khb123456/stm32f103c8t6-balance_car/硬件/平衡车PCB原理图.pdf

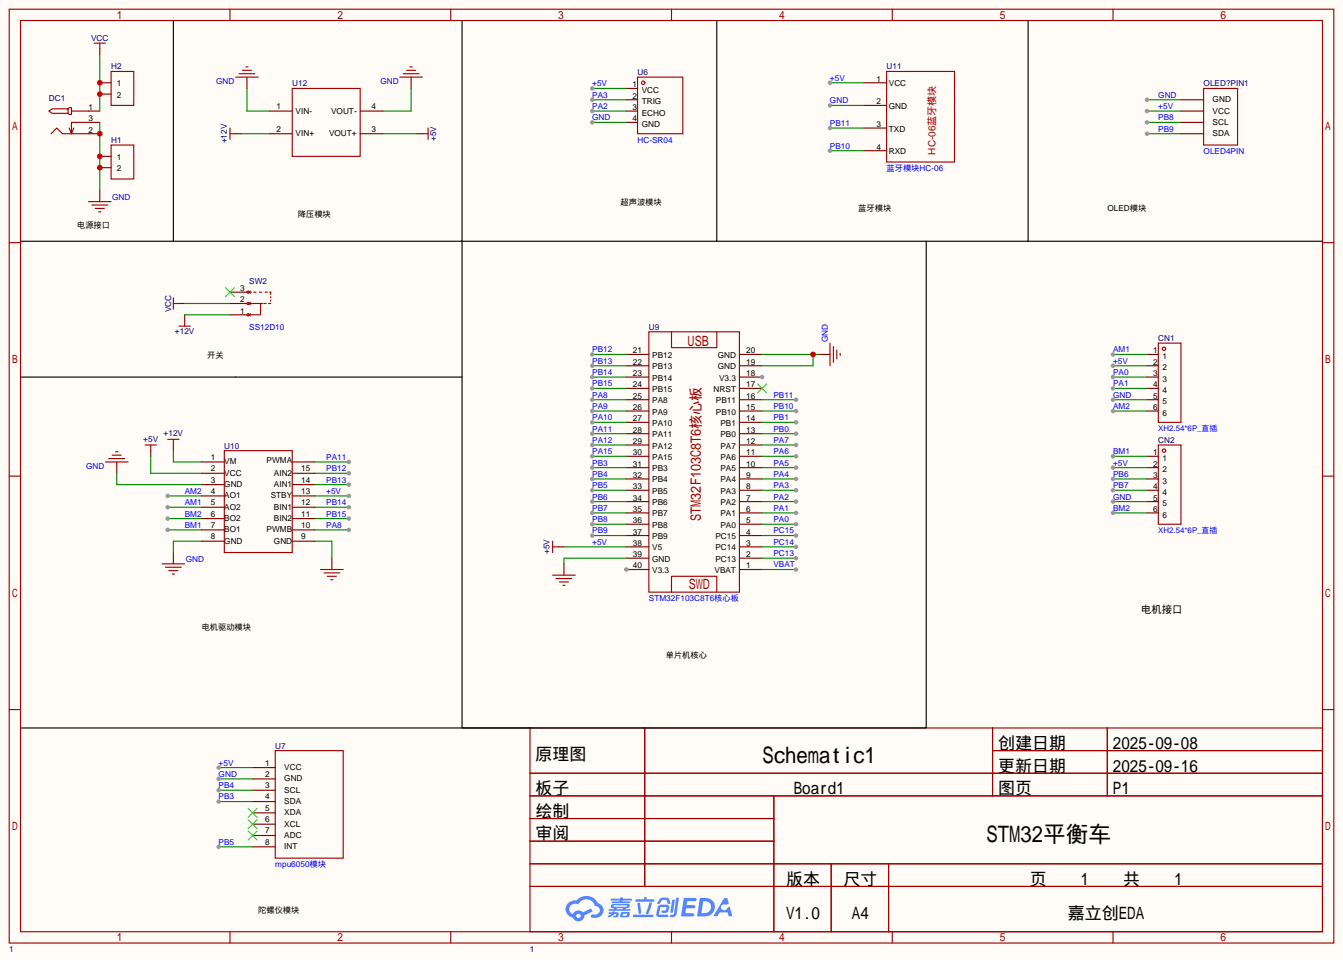
[picture p1: page 1]

原理图 | Schematic1 | 创建日期 | 2025-09-08

更新日期 | 2025-09-16

板子 | Board1 | 图页 | P1
绘制 | | STM32平衡车
审阅

V1.0 | A4 | 嘉立创EDA
