khb123456/stm32f103c8t6-balance_car/(list of files, drawings)

Other design files:
硬件/STM32平衡车PCB.eprj
