khb123456/stm32f103c8t6-balance_car/软件/stm32_balance car/Core/Src/main.c

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
/* Includes ------------------------------------------------------------------*/
#include "main.h"
#include "i2c.h"
#include "tim.h"
#include "usart.h"
#include "gpio.h"

/* USER CODE BEGIN Includes */
#include "OLED.h"
#include "MPU6050.h"
#include "stdio.h"
#include "sr04.h"
#include "motor.h"
#include "encoder.h"
#include "string.h"
#include "task.h"
#include "pid.h"
#include "stdlib.h"
/* USER CODE END Includes */


/* USER CODE BEGIN PV */
int16_t AX, AY, AZ, GX, GY, GZ,Tem;
float AngleAcc;			//由加速度计得到的角度值
float AngleGyro;		//由陀螺仪得到的角度值，执行互补滤波后，此值基本与Angle相等
float Angle;			//互补滤波后的角度值，准确且无漂移


int Encoder_Left,Encoder_Right;
extern float distance;
uint8_t rx_buf[2];
char uart_buf[128];
uint8_t Rx_Flag;
char RxPacket[100];
int16_t LeftPWM, RightPWM;			//左PWM，右PWM
int16_t Ave_PWM, Dif_PWM;				//平均PWM，差分PWM

float LeftSpeed, RightSpeed;		//左速度，右速度
float AveSpeed, DifSpeed;			//平均速度，差分速度
uint8_t Run_Flag;
volatile uint8_t control_flag=0;
PID_TypeDef angle_pid={
	.Kp=0.0f,
	.Ki=0.0f,
	.Kd=0.0f,
	.out_max=90.0f
};
PID_TypeDef speed_pid={
	.Kp=0.0f,
	.Ki=0.0f,
	.Kd=0.0f,
	.integral_max=20,
	.out_max=8.0f
};
PID_TypeDef turn_pid=
{
	.Kp=0.0f,
	.Ki=0.0f,
	.Kd=0.0f,
	.out_max=20.0f
};
/* USER CODE END PV */

void SystemClock_Config(void);
/* USER CODE BEGIN PFP */
void Read(void);
int fputc(int c,FILE *stream);
static void OLED_Proc(void);
void Set_params(void);
void Control(void);

// DWT初始化，开启CYCCNT计数器
void DWT_Init(void)
{
    // 1. 开启DWT和ITM的时钟（必须）
    CoreDebug->DEMCR |= CoreDebug_DEMCR_TRCENA_Msk; 
    // 2. 关闭CYCCNT计数器
    DWT->CTRL &= ~DWT_CTRL_CYCCNTENA_Msk;
    // 3. 清零CYCCNT计数器
    DWT->CYCCNT = 0;
    // 4. 开启CYCCNT计数器
    DWT->CTRL |= DWT_CTRL_CYCCNTENA_Msk;
}

// 读取当前CYCCNT计数器的值（单位：CPU时钟周期）
static inline uint32_t DWT_GetCycle(void)
{
    return DWT->CYCCNT;
}

// 延时函数：微秒级延时（单位：us）
void DWT_Delay_us(uint32_t us)
{
    uint32_t cycles = us * (SystemCoreClock / 1000000); // 换算成需要等待的周期数
    uint32_t start = DWT_GetCycle();
    while ((DWT_GetCycle() - start) < cycles);
}

// 测量一段代码的执行时间（返回单位：us）
float DWT_MeasureTime_us(void (*func)(void))
{
    uint32_t start, end;
    start = DWT_GetCycle();
    func();  // 执行你要测的函数，比如OLED_DMA_Refresh()
    end = DWT_GetCycle();
    return (float)(end - start) / (SystemCoreClock / 1000000);
}
/* USER CODE END PFP */

/**
  * @brief  The application entry point.
  * @retval int
  */
int main(void)
{

  /* MCU Configuration--------------------------------------------------------*/

  /* Reset of all peripherals, Initializes the Flash interface and the Systick. */
  HAL_Init();

  /* Configure the system clock */
  SystemClock_Config();

  /* Initialize all configured peripherals */
  MX_GPIO_Init();
  MX_I2C1_Init();
  MX_TIM3_Init();
  MX_TIM1_Init();
  MX_TIM2_Init();
  MX_TIM4_Init();
  MX_USART3_UART_Init();
  /* USER CODE BEGIN 2 */
  IIC_Init();
  OLED_Init();  
  MPU6050_Init();
  OLED_Clear();
  HAL_TIM_PWM_Start(&htim1,TIM_CHANNEL_1);
  HAL_TIM_PWM_Start(&htim1,TIM_CHANNEL_4);
  HAL_TIM_Encoder_Start(&htim2,TIM_CHANNEL_ALL);
  HAL_TIM_Encoder_Start(&htim4,TIM_CHANNEL_ALL);
  HAL_UART_Receive_IT(&huart3,rx_buf,1);
  Load(0,0);
  MPU6050_SetMode(MODE_COMPLEMENTARY);
  HAL_TIM_Base_Start_IT(&htim3);
  DWT_Init();
  /* USER CODE END 2 */

  /* Infinite loop */
  /* USER CODE BEGIN WHILE */
  PID_Init(&angle_pid);
  PID_Init(&speed_pid);
  PID_Init(&turn_pid);
  Run_Flag=1;
  while (1)
  {
	  Set_params();  
	  if(control_flag)
	  {
		  control_flag=0;
		  Control();
	  }
  }
    /* USER CODE END WHILE */

}

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
/* USER CODE BEGIN 4 */
void Read(void)
{
	static float AveSpeed_Filtered = 0;
	Encoder_Left=Read_Speed(&htim2);
	Encoder_Right=-Read_Speed(&htim4);
	
	LeftSpeed=Encoder_Left/13.0f/4.0f/20.0f/0.01f;
	RightSpeed=Encoder_Right/13.0f/4.0f/20.0f/0.01f;
	
	AveSpeed_Filtered = AveSpeed_Filtered * 0.8f + ((LeftSpeed+RightSpeed)/2.0f) * 0.2f;
	AveSpeed = AveSpeed_Filtered;
	DifSpeed=LeftSpeed-RightSpeed;
	
}

int fputc(int c,FILE *stream)
{
	uint8_t ch[1]={c};
	HAL_UART_Transmit(&huart3,ch,1,0xFFFF);
	return c;
}

void Set_params(void)
{
	if(Rx_Flag==1)
	{
		char *Tag=strtok(RxPacket,",");
		if(strcmp(Tag,"slider")==0)
		{
			char *Name=strtok(NULL,",");
			char *Value=strtok(NULL,",");
			
			if(strcmp(Name,"angle_kp")==0)
			{
				angle_pid.Kp=atof(Value);
			}
			else if(strcmp(Name,"angle_ki")==0)
			{
				angle_pid.Ki=atof(Value);
			}
			else if(strcmp(Name,"angle_kd")==0)
			{
				angle_pid.Kd=atof(Value);
			}
			else if(strcmp(Name,"speed_kp")==0)
			{
				speed_pid.Kp=atof(Value);
			}
			else if(strcmp(Name,"speed_ki")==0)
			{
				speed_pid.Ki=atof(Value);
			}
			else if(strcmp(Name,"speed_kd")==0)
			{
				speed_pid.Kd=atof(Value);
			}
			else if(strcmp(Name,"turn_kp")==0)
			{
				turn_pid.Kp=atof(Value);
			}
			else if(strcmp(Name,"turn_ki")==0)
			{
				turn_pid.Ki=atof(Value); 
			}
			else if(strcmp(Name,"turn_kd")==0)
			{
				turn_pid.Kd=atof(Value);
			}

		}
		else if (strcmp(Tag, "joystick") == 0)			//Tag为joystick，收到摇杆数据包
			{
				int8_t LH = atoi(strtok(NULL, ","));		//提取数据2，定义为摇杆值LH
				int8_t LV = atoi(strtok(NULL, ","));		//提取数据3，定义为摇杆值LV
				int8_t RH = atoi(strtok(NULL, ","));		//提取数据4，定义为摇杆值RH
				int8_t RV = atoi(strtok(NULL, ","));		//提取数据5，定义为摇杆值RV
				
				/*执行摇杆操作*/
				speed_pid.target = LV / 25.0;	//摇杆值LV缩放后，控制速度环目标值，前后行进控制
				turn_pid.target = RH / 2;				//摇杆值RH缩放后，控制差分PWM，左右转弯控制
			}
		
			Rx_Flag=0;

	}
//	printf("[plot,%f,%f]",angle_pid.target,angle_pid.actual);
}

void Control(void)
{
		MPU6050_Mode_Update();
		angle_pid.actual = MPU6050_GetPitch();
//		OLED_Clear();
//	    OLED_Printf(0,0,12,"Pitch:%f",angle_pid.actual);
//		OLED_Update();
//	printf("Pitch:%f\r\n",angle_pid.actual);
		 /* 超限保护 */
		if (angle_pid.actual > 50.0f || angle_pid.actual < -50.0f) 
		{
			Load(0,0);
			Run_Flag=0;
		}
		if(Run_Flag)
		{
		speed_pid.actual=AveSpeed;

		PID_Calculate(&speed_pid);
		angle_pid.target=-speed_pid.out-2.95f;
		
		PID_Calculate(&angle_pid);
		Ave_PWM = -((int)angle_pid.out);
					
		turn_pid.actual=DifSpeed;
		PID_Calculate(&turn_pid);
		Dif_PWM=turn_pid.out;
			
		LeftPWM = Ave_PWM + Dif_PWM/2;
		RightPWM = Ave_PWM - Dif_PWM/2;

		/* 输出限幅 */
		if (LeftPWM > 100) LeftPWM = 100;
		if (LeftPWM < -100) LeftPWM = -100;
		if (RightPWM > 100) RightPWM = 100;
		if (RightPWM < -100) RightPWM = -100;

		Load(LeftPWM, RightPWM);
	    }
		else
		{
		Load(0,0);
		}
	
}
void HAL_UART_RxCpltCallback(UART_HandleTypeDef *huart)
{
	static uint8_t RxState=0;
	static uint8_t pRxPacket=0;

	if(huart->Instance==USART3)
	{
		if(RxState==0)
		{
			if(rx_buf[0]=='['&&Rx_Flag==0)
			{
				RxState=1;
				pRxPacket=0;
			}
		}
		
		else if(RxState==1)
		{
			if(rx_buf[0]==']')
			{
				RxState=0;
				RxPacket[pRxPacket]='\0';
				Rx_Flag=1;
			}
			else
		{
			RxPacket[pRxPacket]=rx_buf[0];
			pRxPacket++;
		}
		}

		HAL_UART_Receive_IT(&huart3,rx_buf,1);
	}
}

void HAL_TIM_PeriodElapsedCallback(TIM_HandleTypeDef *htim)
{
	static uint16_t Count0,Count1;
	if (htim->Instance == TIM3) 
	 {
		Count0++;
		 if(Count0>=10)
		 {
			Count0=0;
			control_flag=1;	
		 }
		 Count1++;
		 if(Count1>=10)
		 {
			Count1=0;
			 Read();
		 }
	 
	 }
}
/* USER CODE END 4 */
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
