khb123456/stm32f103c8t6-balance_car/软件/stm32_balance car/MDK-ARM/.eide/eide.yml

version: "4.1"
name: stm32_balance car
type: ARM
deviceName: null
packDir: null
srcDirs: []
virtualFolder:
  name: <virtual_root>
  files: []
  folders:
    - name: Application
      files: []
      folders:
        - name: MDK-ARM
          files:
            - path: startup_stm32f103xb.s
          folders: []
        - name: User
          files: []
          folders:
            - name: Core
              files:
                - path: ../Core/Src/OLED.c
                - path: ../Core/Inc/OLED.h
                - path: ../Core/Inc/OLED_Font.h
                - path: ../Core/Src/OLED_Font.c
                - path: ../Core/Src/MPU6050.c
                - path: ../Core/Inc/MPU6050.h
                - path: ../Core/Inc/MyI2C.h
                - path: ../Core/Src/MyI2C.c
                - path: ../Core/Src/sr04.c
                - path: ../Core/Inc/sr04.h
                - path: ../Core/Src/motor.c
                - path: ../Core/Inc/motor.h
                - path: ../Core/Src/encoder.c
                - path: ../Core/Inc/encoder.h
                - path: ../Core/Inc/task.h
                - path: ../Core/Src/inv_mpu.c
                - path: ../Core/Src/inv_mpu_dmp_motion_driver.c
                - path: ../Core/Inc/dmpKey.h
                - path: ../Core/Inc/dmpmap.h
                - path: ../Core/Inc/inv_mpu.h
                - path: ../Core/Inc/inv_mpu_dmp_motion_driver.h
                - path: ../Core/Inc/pid.h
                - path: ../Core/Src/pid.c
                - path: ../Core/Inc/i2c_bus.h
                - path: ../Core/Src/i2c_bus.c
                - path: ../Core/Src/main.c
                - path: ../Core/Src/gpio.c
                - path: ../Core/Src/i2c.c
                - path: ../Core/Src/tim.c
                - path: ../Core/Src/usart.c
                - path: ../Core/Src/stm32f1xx_it.c
                - path: ../Core/Src/stm32f1xx_hal_msp.c
              folders: []
    - name: Drivers
      files: []
      folders:
        - name: STM32F1xx_HAL_Driver
          files:
            - path: ../Drivers/STM32F1xx_HAL_Driver/Src/stm32f1xx_hal_gpio_ex.c
            - path: ../Drivers/STM32F1xx_HAL_Driver/Src/stm32f1xx_hal_i2c.c
            - path: ../Drivers/STM32F1xx_HAL_Driver/Src/stm32f1xx_hal.c
            - path: ../Drivers/STM32F1xx_HAL_Driver/Src/stm32f1xx_hal_rcc.c
            - path: ../Drivers/STM32F1xx_HAL_Driver/Src/stm32f1xx_hal_rcc_ex.c
            - path: ../Drivers/STM32F1xx_HAL_Driver/Src/stm32f1xx_hal_gpio.c
            - path: ../Drivers/STM32F1xx_HAL_Driver/Src/stm32f1xx_hal_dma.c
            - path: ../Drivers/STM32F1xx_HAL_Driver/Src/stm32f1xx_hal_cortex.c
            - path: ../Drivers/STM32F1xx_HAL_Driver/Src/stm32f1xx_hal_pwr.c
            - path: ../Drivers/STM32F1xx_HAL_Driver/Src/stm32f1xx_hal_flash.c
            - path: ../Drivers/STM32F1xx_HAL_Driver/Src/stm32f1xx_hal_flash_ex.c
            - path: ../Drivers/STM32F1xx_HAL_Driver/Src/stm32f1xx_hal_exti.c
            - path: ../Drivers/STM32F1xx_HAL_Driver/Src/stm32f1xx_hal_tim.c
            - path: ../Drivers/STM32F1xx_HAL_Driver/Src/stm32f1xx_hal_tim_ex.c
            - path: ../Drivers/STM32F1xx_HAL_Driver/Src/stm32f1xx_hal_uart.c
          folders: []
        - name: CMSIS
          files:
            - path: ../Core/Src/system_stm32f1xx.c
          folders: []
    - name: ::CMSIS
      files: []
      folders: []
dependenceList: []
outDir: build
miscInfo:
  uid: 3875a8a90c1280a5a0544480e508a740
targets:
  stm32_balance car:
    cppPreprocessAttrs:
      defineList:
        - USE_HAL_DRIVER
        - STM32F103xB
      incList:
        - ../Core/Inc
        - ../Drivers/STM32F1xx_HAL_Driver/Inc
        - ../Drivers/STM32F1xx_HAL_Driver/Inc/Legacy
        - ../Drivers/CMSIS/Device/ST/STM32F1xx/Include
        - ../Drivers/CMSIS/Include
        - .cmsis/include
        - RTE/_stm32_balance car
      libList: []
    excludeList: []
    settings: {}
    toolchain: AC5
    toolchainConfigMap:
      AC5:
        archExtensions: ""
        cpuType: Cortex-M3
        floatingPointHardware: none
        options:
          version: 4
          afterBuildTasks: []
          asm-compiler:
            defines: []
          beforeBuildTasks: []
          c/cpp-compiler:
            CXX_FLAGS: --diag_suppress=1 --diag_suppress=1295
            C_FLAGS: --diag_suppress=1 --diag_suppress=1295
            c99-mode: true
            one-elf-section-per-function: true
            optimization: level-0
            warnings: all-warnings
          global:
            output-debug-info: enable
            use-microLIB: true
          linker:
            $outputTaskExcludes:
              - .bin
            output-format: elf
            ro-base: ""
            rw-base: ""
            xo-base: ""
        scatterFilePath: ""
        storageLayout:
          RAM:
            - id: 1
              isChecked: false
              mem:
                size: "0x0"
                startAddr: "0x0"
              noInit: false
              tag: RAM
            - id: 2
              isChecked: false
              mem:
                size: "0x0"
                startAddr: "0x0"
              noInit: false
              tag: RAM
            - id: 3
              isChecked: false
              mem:
                size: "0x0"
                startAddr: "0x0"
              noInit: false
              tag: RAM
            - id: 1
              isChecked: true
              mem:
                size: "0x5000"
                startAddr: "0x20000000"
              noInit: false
              tag: IRAM
            - id: 2
              isChecked: false
              mem:
                size: "0x0"
                startAddr: "0x0"
              noInit: false
              tag: IRAM
          ROM:
            - id: 1
              isChecked: false
              isStartup: false
              mem:
                size: "0x0"
                startAddr: "0x0"
              tag: ROM
            - id: 2
              isChecked: false
              isStartup: false
              mem:
                size: "0x0"
                startAddr: "0x0"
              tag: ROM
            - id: 3
              isChecked: false
              isStartup: false
              mem:
                size: "0x0"
                startAddr: "0x0"
              tag: ROM
            - id: 1
              isChecked: true
              isStartup: true
              mem:
                size: "0x10000"
                startAddr: "0x8000000"
              tag: IROM
            - id: 2
              isChecked: false
              isStartup: false
              mem:
                size: "0x0"
                startAddr: "0x0"
              tag: IROM
        useCustomScatterFile: false
    uploadConfigMap:
      JLink:
        baseAddr: ""
        bin: ""
        cpuInfo:
          cpuName: "null"
          vendor: "null"
        otherCmds: ""
        proType: 1
        speed: 8000
      STLink:
        address: "0x8000000"
        bin: ""
        elFile: None
        optionBytes: .eide/stm32_balance car.st.option.bytes.ini
        otherCmds: ""
        proType: SWD
        resetMode: default
        runAfterProgram: true
        speed: 4000
    uploader: STLink
