khb123456/stm32f103c8t6-balance_car/软件/stm32_balance car/Core/Inc/main.h

#define ECHO_Pin GPIO_PIN_2
#define ECHO_GPIO_Port GPIOA
#define ECHO_EXTI_IRQn EXTI2_IRQn
#define TRIG_Pin GPIO_PIN_3
#define TRIG_GPIO_Port GPIOA
#define AIN2_Pin GPIO_PIN_12
#define AIN2_GPIO_Port GPIOB
#define AIN1_Pin GPIO_PIN_13
#define AIN1_GPIO_Port GPIOB
#define BIN1_Pin GPIO_PIN_14
#define BIN1_GPIO_Port GPIOB
#define BIN2_Pin GPIO_PIN_15
#define BIN2_GPIO_Port GPIOB
#define IIC_SDA_Pin GPIO_PIN_3
#define IIC_SDA_GPIO_Port GPIOB
#define IIC_SCL_Pin GPIO_PIN_4
#define IIC_SCL_GPIO_Port GPIOB
