khb123456/stm32f103c8t6-balance_car/软件/stm32_balance car/Core/Src/motor.c

#include "motor.h"
#include "tim.h"

#define PWM_MAX 100
#define PWM_MIN -100

int abs(int p)
{
	if(p>0)
		return p;
	else
		return -p;
}

void Load(int motor1,int motor2)
{
	if(motor1<0)
	{
		HAL_GPIO_WritePin(AIN1_GPIO_Port,AIN1_Pin,GPIO_PIN_SET);
		HAL_GPIO_WritePin(AIN2_GPIO_Port,AIN2_Pin,GPIO_PIN_RESET);
	}
	else
	{
		HAL_GPIO_WritePin(AIN1_GPIO_Port,AIN1_Pin,GPIO_PIN_RESET);
		HAL_GPIO_WritePin(AIN2_GPIO_Port,AIN2_Pin,GPIO_PIN_SET);
	}
	__HAL_TIM_SetCompare(&htim1,TIM_CHANNEL_4,abs(motor1));
		if(motor2<0)
	{
		HAL_GPIO_WritePin(BIN1_GPIO_Port,BIN1_Pin,GPIO_PIN_SET);
		HAL_GPIO_WritePin(BIN2_GPIO_Port,BIN2_Pin,GPIO_PIN_RESET);
	}
	else
	{
		HAL_GPIO_WritePin(BIN1_GPIO_Port,BIN1_Pin,GPIO_PIN_RESET);
		HAL_GPIO_WritePin(BIN2_GPIO_Port,BIN2_Pin,GPIO_PIN_SET);
	}
	__HAL_TIM_SetCompare(&htim1,TIM_CHANNEL_1,abs(motor2));
}

void Limit(int *motoA,int *motoB)
{
	if(*motoA>PWM_MAX)*motoA=PWM_MAX;
	if(*motoA<PWM_MIN)*motoA=PWM_MIN;
	if(*motoB>PWM_MAX)*motoB=PWM_MAX;
	if(*motoB<PWM_MIN)*motoB=PWM_MIN;
}
