khb123456/stm32f103c8t6-balance_car/软件/stm32_balance car/Core/Inc/pid.h

#ifndef __PID_H
#define __PID_H

#include "main.h"

typedef struct{
	float Kp;
	float Ki;
	float Kd;
	float target;
	float actual;
	float error;
	float error_last;
	float integral;
	float integral_max;
	float dif;
	float out;
	float out_max;
}PID_TypeDef;
void PID_Calculate(PID_TypeDef *pid);
void PID_Init(PID_TypeDef *pid);
#endif
