khb123456/stm32f103c8t6-balance_car/软件/stm32_balance car/Core/Src/MyI2C.c

#include "MyI2C.h"

void IIC_W_SCL(uint8_t BitValue)
{
    HAL_GPIO_WritePin(SCL_PORT, SCL_PIN, (GPIO_PinState)BitValue); 
//    HAL_Delay_us(10);                                                    
}

void IIC_W_SDA(uint8_t BitValue)
{
    HAL_GPIO_WritePin(SDA_PORT, SDA_PIN, (GPIO_PinState)BitValue); 
//    HAL_Delay_us(10);                                                     
}


uint8_t IIC_R_SDA(void)
{
    uint8_t BitValue;
    BitValue = (uint8_t)HAL_GPIO_ReadPin(SDA_PORT, SDA_PIN); 
    HAL_Delay_us(10);                                               
    return BitValue;                                           
}
void IIC_Init(void)
{
	HAL_Delay(100);
	IIC_W_SDA(1);                            
    IIC_W_SCL(1);
	HAL_Delay_us(50);
}

void IIC_Start(void)
{
    IIC_W_SDA(1);                            
    IIC_W_SCL(1);                             
    IIC_W_SDA(0);                             
    IIC_W_SCL(0);                             
}

void IIC_Stop(void)
{
    IIC_W_SDA(0);                            
    IIC_W_SCL(1);                           
    IIC_W_SDA(1);                             
}

void IIC_SendByte(uint8_t Byte)
{
    uint8_t i;
    for (i = 0; i < 8; i++)                    
    {
        
        IIC_W_SDA(!!(Byte & (0x80 >> i)));    
        IIC_W_SCL(1);                         
        IIC_W_SCL(0);                         
    }
}

uint8_t IIC_ReceiveByte(void)
{
    uint8_t i, Byte = 0x00;                     
    IIC_W_SDA(1);                             
    for (i = 0; i < 8; i++)                     
    {
        IIC_W_SCL(1);                         
        if (IIC_R_SDA()) { Byte |= (0x80 >> i); } 
                                                    
        IIC_W_SCL(0);                         
    }
    return Byte;                                
}

void IIC_SendAck(uint8_t AckBit)
{
    IIC_W_SDA(AckBit);                       
    IIC_W_SCL(1);                             
    IIC_W_SCL(0);                             
}

uint8_t IIC_ReceiveAck(void)
{
    uint8_t AckBit;                             
    IIC_W_SDA(1);                            
    IIC_W_SCL(1);                            
    AckBit = IIC_R_SDA();                    
    IIC_W_SCL(0);                             
    return AckBit;                               
}
