khb123456/stm32f103c8t6-balance_car/(commit log)

2026-04-06 第一次提交：项目初始化完成
    [STM32平衡车PCB.eprj]
2026-04-06 Initialize README with project details
    Add project overview and hardware/software details for STM32F103C8T6 self-balancing vehicle.
2026-04-07 优化了MPU6050读取寄存器的代码，提高了MPU6050读取效率
2026-04-08 解决了互补滤波和卡尔曼滤波下，MPU6050响应延迟的问题
2026-04-08 加入了角度环，但是调参效果不理想
2026-04-19 替换了OLED驱动
2026-04-20 解决了响应延迟的问题，但小车还是不能直立
2026-04-20 调整了互补滤波系数，加上调节角度环参数，实现了小车直立
2026-04-22 暂存PID程序，角度环已实现直立，接下来准备重新调整结构程序，实现串级pid
2026-04-22 添加了速度环和转向环，目前速度环还存在问题
2026-04-24 完成PID程序编写
2026-04-25 优化了OLED相关程序，解决了OLED刷新耗时阻塞程序的问题
2026-05-18 由于加入DMA会打乱MPU6050的时序，所以放弃了DMA刷新OLED，采用显示缓存区和多字节发送，并完善了PID代码，还差PID程序的参数整定
2026-06-12 项目大体完成，尚存许多不足
