khb123456/stm32f103c8t6-balance_car/(notices)

Notices in the files:
软件/stm32_balance car/Core/Inc/main.h:
Copyright (c) 2026 STMicroelectronics.
All rights reserved.
This software is licensed under terms that can be found in the LICENSE file
